gamzeceliikk/UGAN-Powertronics/EE464_HW#2.pdf

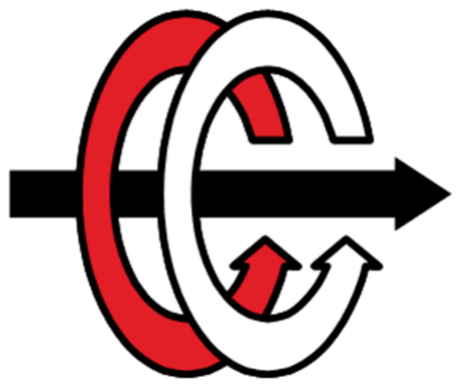
[picture p1: figure]

# ELECTRICAL & ELECTRONICS ENGINEERING DEPARTMENT

## STATIC POWER CONVERSION II

### FLYBACK CONVERTER DESIGN: SIMULATION RESULTS

by

Ahmet Can YULAF 2376234

Gamze ÇELİK 23043227

Utku Deniz ALTIOK 2347596

Ahmet Can YULAF | Gamze ÇELİK | Utku Deniz ALTIOK

### 1. Introduction

Isolated DC/DC converters have several benefits over non-isolated converters. The main reason for the isolation is safety. Flyback converter is one of the isolated DC/DC converter topologies. This report focuses on how to determine open-loop parameters for the 48W flyback converter and verification of the determined parameters.

### 2. Open-Loop Parameters Selection

Flyback converter has the following gain relation.
| V o = D 1−D *

NS
NP

* V
in
According to the gain relation of the converter,

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
−> 4 ≥

D
1−D

*

NS
NP
| | ≥ 2. 67
Moreover, duty cycle is desired to be less than or equal to 0.5. Thus, turn ratio of the
transformer is chosen as n = | and the switching frequency of the converter to be

NS
NP

= 4
designed as 50 kHz.

Given turn ratio and frequency, the following parameters can be computed as follows.

V

DS,max = V

in,max + V

| Reflected + V DS,max | * 0. 3 (due to leakage ringing)
0. 7V | So
DS,max = 18 + (48 + 0. 7) * 1/4 | V
DS,max
| | ≈ 45 V
| Dmax = V R V R+V in,min = 0. 505

P

in,max =

P
out,max
eff

(assuming %85 efficiency) = 48/0. 85 ≈ 56. 5 W

I

P =

2*P
| in,max
V
in,min
| *Dmax = 2*56.5
12*0.505 | ≈ 18. 65 A

L

p,max =

V
in,min

*Dmax
I
P

*f
sw

=

| 12*0.505
18.65*50000 | = 6. 5 * 10
| | −6 H = 6. 5 µH

For the core to be used is a ferrite core, with the assumption that BSat = 0.24 T. BSat values can be in the range of 0.2 - 0.34 Tesla according to papers. Moreover, we found a core that has 125 mm² Ae

N

P =

L
p,max

*I
P
BSat

*A
e
| = 6.5*10 −6 *18.65
0.24*0.000125 | ≈ 4 Turns
So, we will have 4 turns at the primary side. At this point, one issue about inductance factor of the core chosen arises. The problem is that primary inductance calculated from the given primary turns exceeds the primary inductance limit for the discontinuous conduction mode. However, datasheet contains any information about DC performance of the core. Therefore, it will be assumed that core will have 6.5 µH for 4 primary turns due to its non-provided DC performance. This issue will be investigated before the incorporation of the designed transformer.

I

p,rms = I
p,peak
| * Dmax

/3 = 18. 65 * 0. 505/3 = 7. 65 A

2 | Flyback Converter Design – Simulation Report

I

s,peak = I
P

* 1/4 = 4. 67 A I

s,rms = 4. 67 *

1−0.505
3 = 1. 9 A

According to the table above we should choose AWG23 for 50 kHz operation. However, it has a 0.729A maximum current capacity, so it can be wired as parallel.

For the primary side, wire should contain at least 11 cables to satisfy current condition. This means there will be 44 AWG23 cable at the window for primary. For Secondary only 3 parallel cables are needed for secondary wire. Thus, there will be 48 cables at the window. Each cable has 0.258 mm² area. There will be a total of 92 cables at the window, which makes 24 mm² winding area. Since they are wired as parallel, it will probably be higher, 30 mm² so to say. Winding area of the coil former is 75 mm²
, which makes fill factor 0.4. It is a reasonable fill factor.

V

RV,diode = V
out

+ V
in,max

* n = 48 + 18 * 4 = 120 V

According to the design guides VRRM should be at least 30% higher than VRV,diode and IF (average forward current) is at least 50% higher than the Is,rms

. So VRRM should be around 156 V and IF should be around 2.9 A

C

out,min =

I
out,max

*NCP
f
sw

*V
Ripple

NCP is the number of internal clock cycles needed by the control loop to reduce the duty cycle from maximum to minimum value. This usually takes around 10-20 switching periods.

Vo,ripple will be 1.44V if the ripple voltage is set to be 3% of the average output voltage.

So C
out,min =

1*15
50000*1.44 = 208. 3 * 10

−6
F = 208. 3 µF = 0. 21 mF

I

c,rms,min = I
s,rms

2 − I
Out

2 = 1. 62 A

ESR

max <

∆V
Out
I
s,peak

= 1. 44/1. 9 = 0. 76

Above calculations are decent except the capacitor value which is probably too high it has very low ripple in simulations so we try a different approach

∆V | . To stay in the safe region we shall
O

/V

O =

D
RCf = 0. 03 =

0.51
48*C*50000 => C = 7. 1 µF
use 10 µF

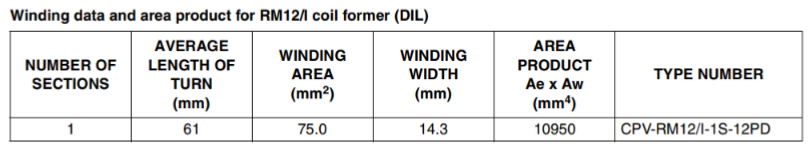
[picture p2: figure]

In the datasheet of the coil former, (https://www.digikey.com/en/products/detail/ferroxcube/CPV-RM12-I-1S-12PD-TZ/7034242) it says the average length of a single turn is 61 mm. AWG23 has 66.8 Ω/km resistance, which is 6. 68 * 10 Ω/m. As cables will be wired as

−5
parallel, the total resistance can be calculated as the formula given below.

ρ =

Number of Turns *61*6.68*10

−5
Number of Paralleled Cables

ρ

p =

4*61*6.68*10

−5
11 = 0. 0015Ω

ρ

s =

16*61*6.68*10

−5
3 | = 0. 022Ω

The AWG23 cable has 100% skin depth at the frequency about 50kHz. Therefore, AC resistance will be equal to DC resistance.

P

p,copper = I
RMS

2
* R = 7. 65

2
* 0. 0015 = 0. 09 W P s,copper = 1. 9

2
* 0. 022 = 0. 08 W

P

total,copper = P

s,copper + P

p,copper = 170 mWatts

L

M =

(V
in,min

*Dmax

)

2

2*Pin*f
sw

=

(12*0.505)

2
2*56.5*50000 = 6. 5 µH

∆I

L =

V
inMin

*Dmax
LM

*f
SW

=

12*0.505
6.5*10

−6
*50000

= 18. 65A

I

EDC =

P
in
V
in,min

*Dmax

=

56.5
12*0.505 = 9. 32A

I

DS,peak = I

EDC + ∆I/2 = 18. 65A

I

DS,rms = (3 * I
EDC

2
+ (∆I/2)

2
) * Dmax

/3 = 7. 65A

N

P,min =

LM

*I
Over
BSat

*A
e

* 10

6 = 4 turns

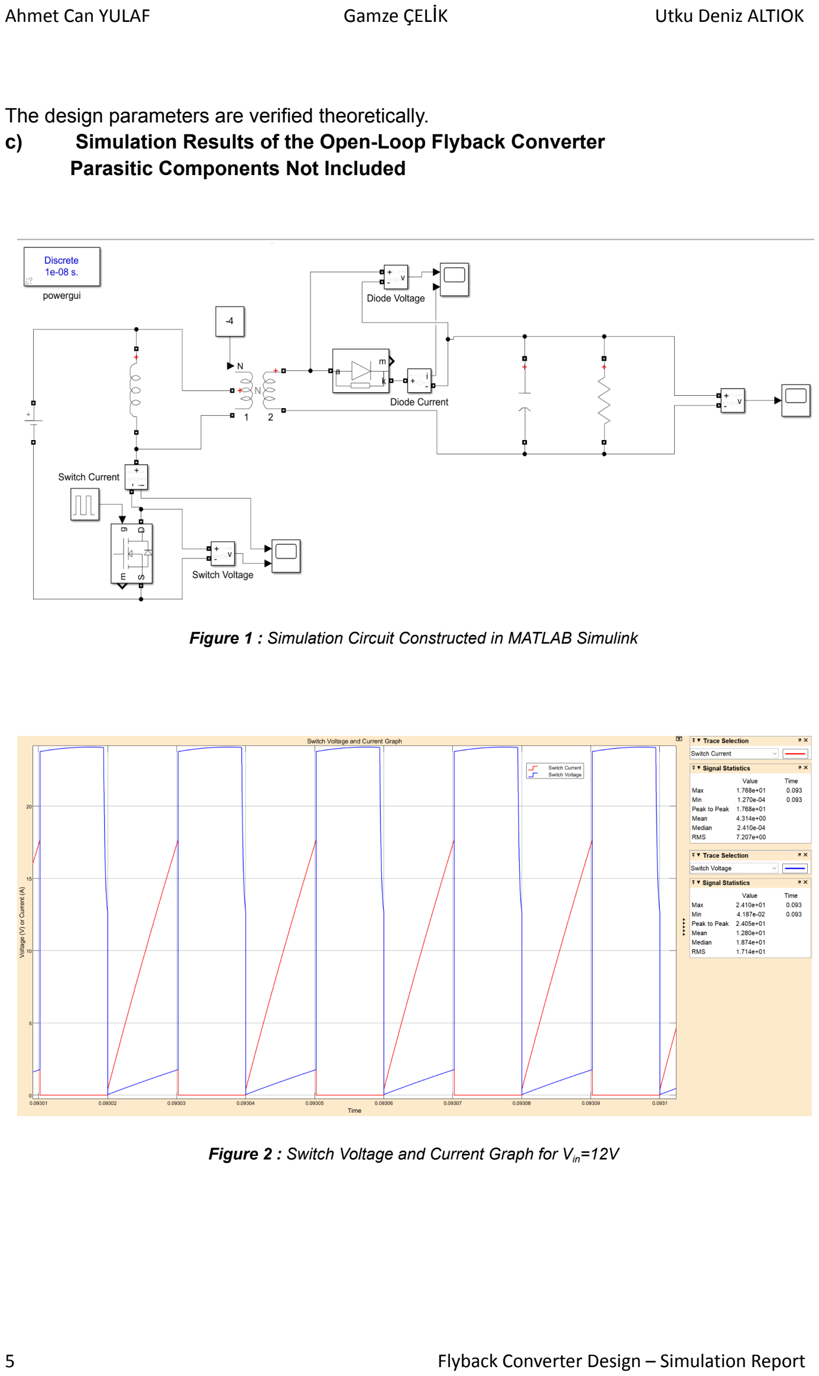
[picture p3: page 5]

The design parameters are verified theoretically.
c) Simulation Results of the Open-Loop Flyback Converter Parasitic Components Not Included

Figure 1 : Simulation Circuit Constructed in MATLAB Simulink

Figure 2 : Switch Voltage and Current Graph for Vin=12V

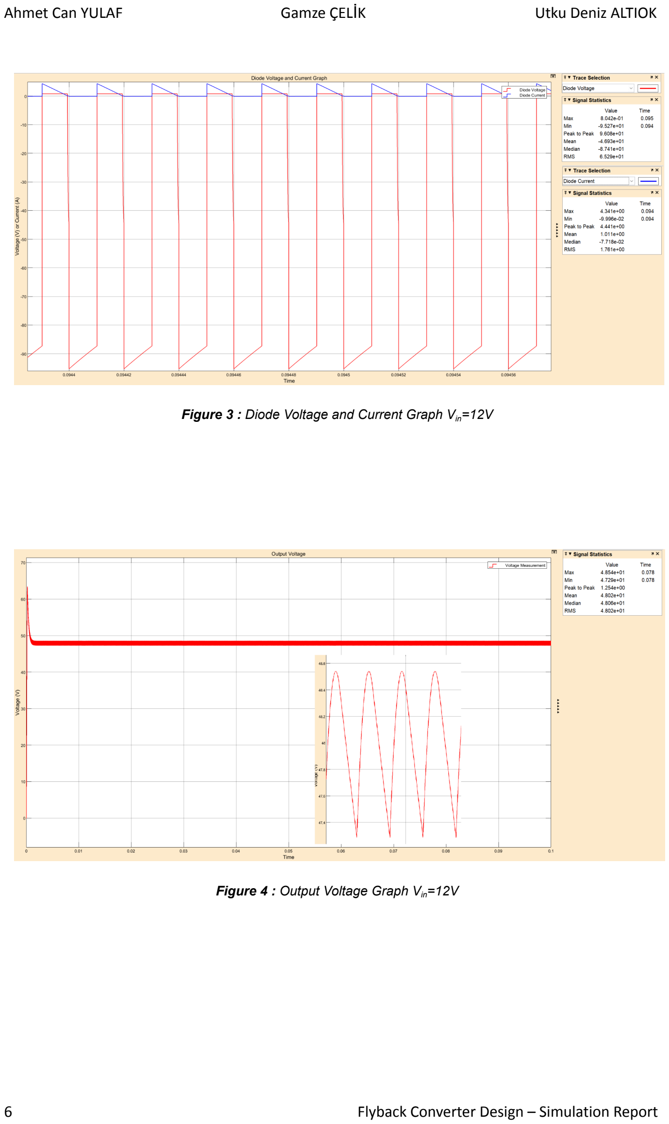
[picture p4: page 6]

Figure 3 : Diode Voltage and Current Graph Vin=12V

Figure 4 : Output Voltage Graph Vin=12V

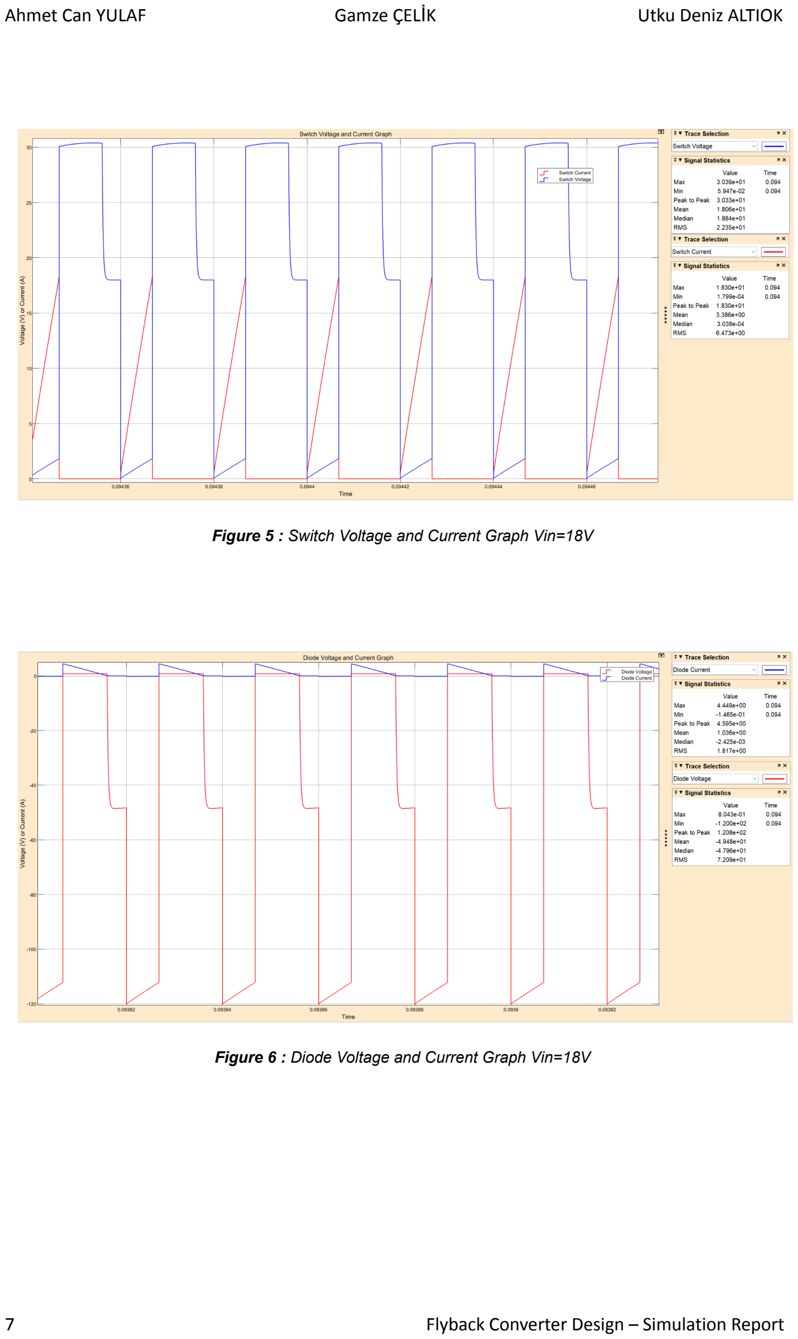
[picture p5: page 7]

Figure 5 : Switch Voltage and Current Graph Vin=18V

Figure 6 : Diode Voltage and Current Graph Vin=18V

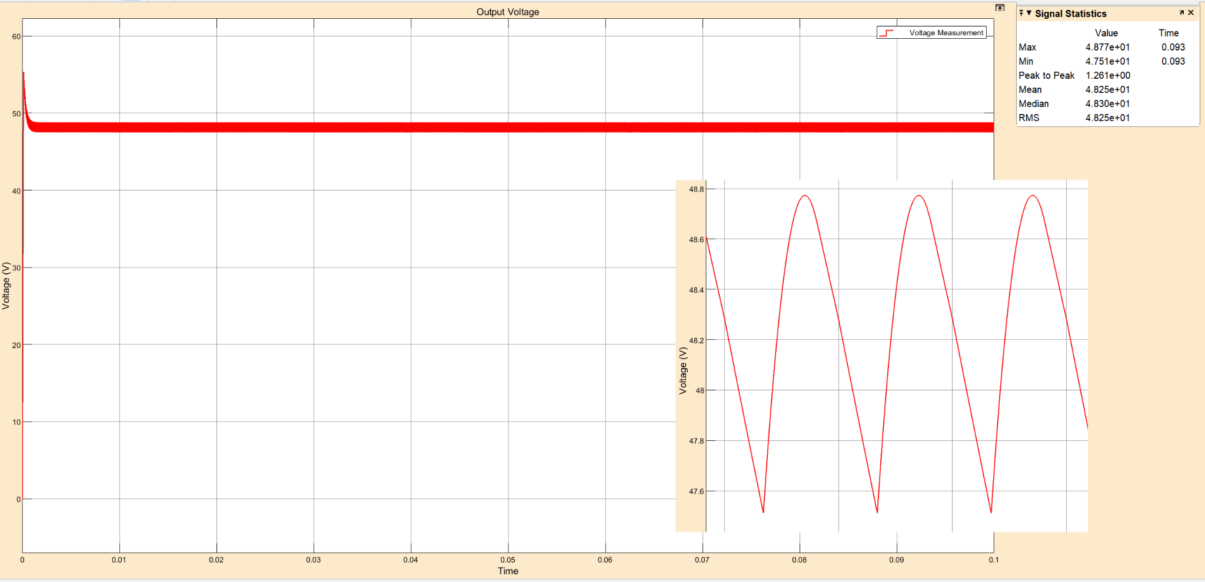
[picture p6: figure]

Figure 7 : Output Voltage Graph Vin=18

d)
DCM will occur at low Vin if it will occur, so at V | and we have N2/N1 =4, and
In = 12 V
Lm = 6.5 uH but it was chosen to operate at the vicinity of the boundary according to the design guides so let's assume it is 10 uH for this question to operate in the ccm mode. The
other values were ; f | .
SW = 50 kHz R = 48 Ω D = 0. 52 C | Out = 10 uF
so ∆I | so at the
L =

V
inMin

*Dmax LM *f SW
=

12*0.52 10*10 −6 *50000
= 12. 5A tℎen I | LAvg = 6. 25 A
secondary side 6.25/4= 1.56 A

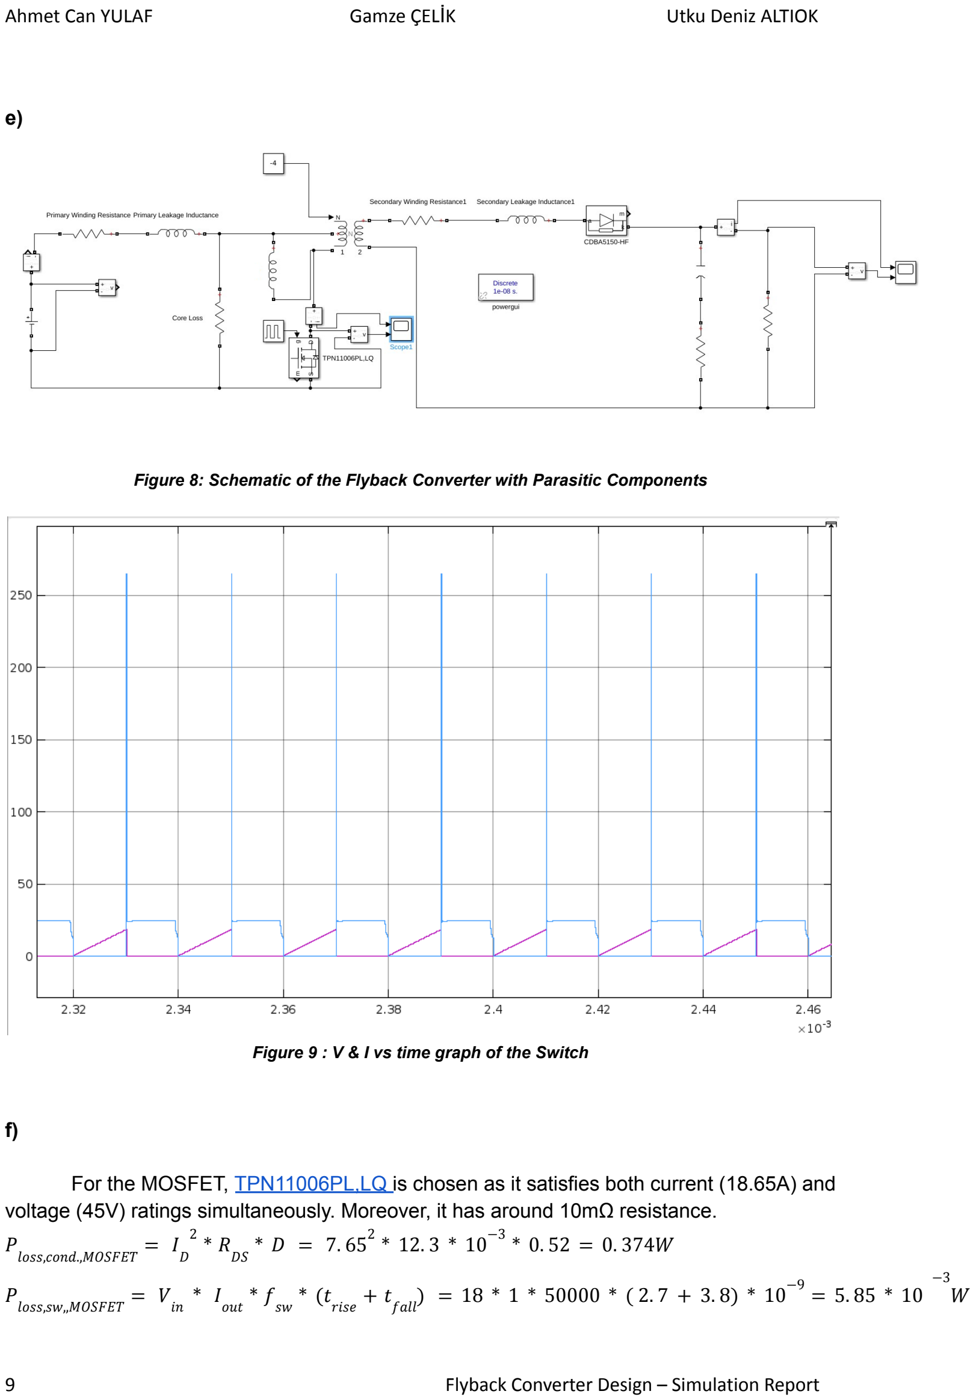
[picture p7: page 9]

e)

Figure 8: Schematic of the Flyback Converter with Parasitic Components

Figure 9 : V & I vs time graph of the Switch

f)

For the MOSFET, TPN11006PL,LQ (https://www.digikey.com/en/products/detail/toshiba-semiconductor-and-storage/TPN11006PL-LQ/10447100) is chosen as it satisfies both current (18.65A) and voltage (45V) ratings simultaneously. Moreover, it has around 10mΩ resistance.

P

loss,cond.,MOSFET = I
D

2
* R
DS

* D = 7. 65

2
* 12. 3 * 10

−3
* 0. 52 = 0. 374W

P

loss,sw,,MOSFET = V
in

* I
out

* f
sw

* (t

rise + t
fall

) = 18 * 1 * 50000 * ( 2. 7 + 3. 8) * 10

−9 = 5. 85 * 10

−3
W

For the diode, CDBA5150-HF (https://www.digikey.com/en/products/detail/comchip-technology/CDBA5150-HF/3308146) is chosen as it satisfies both current (1.9Aavg & 4.6Apeak) and voltage (120V) RATİNGS SİMULTANEOUSLY. Moreover, it has around 0.75V forward voltage drop on it.

P

loss,cond,,diode = V
f

* I
avg

* (1 − D) = 0. 87 * 1. 9 * 0. 48 = 0. 793W Switching losses on the schottky diodes are negligible

For the output capacitor, ESK106M100AE3EA (https://www.digikey.com/en/products/detail/kemet/ESK106M100AE3EA/9448267) is chosen. According to the datasheet, ESR is calculated with the formula given below.

R

ESR =

tanδ
ω*C = 63. 66mΩ

Core loss under specific conditions has been provided by the core manufacturer. However, there exists no data at 50kHz and 0.24T. However, there is a direct relation between frequency and core loss. Therefore, the core loss will be approximated as the half of the loss at 100kHz.

Leakage inductance is subjected to the winding method. Therefore, there can not be formulation about leakage inductance. For this converter, leakage inductance will be assumed to be 1% of the magnetizing inductance and the secondary side is assumed to be reflected inductance of primary leakage inductance.

L

l,1 = 0. 01 * L

M =

L
l,2
n

2 −> L

l,2 = L
l,1

* n

2

# References

1 https://www.mouser.com/pdfdocs/2-8.pdf
2 https://www.digikey.com/en/products/detail/ferroxcube/CPV-RM12-I-1S-12PD-TZ/7034242 3 https://www.ferroxcube.com/upload/media/product/file/Pr_ds/RM12_ILP.pdf
4 https://tr.farnell.com/awg-donusturme-hesaplayicisi
5 https://www.onsemi.jp/pub/collateral/an-4140jp.pdf
