gamzeceliikk/UGAN-Powertronics/Simulation Plots/Diode Current and Voltage Graph Vin=12, D=0.52.png

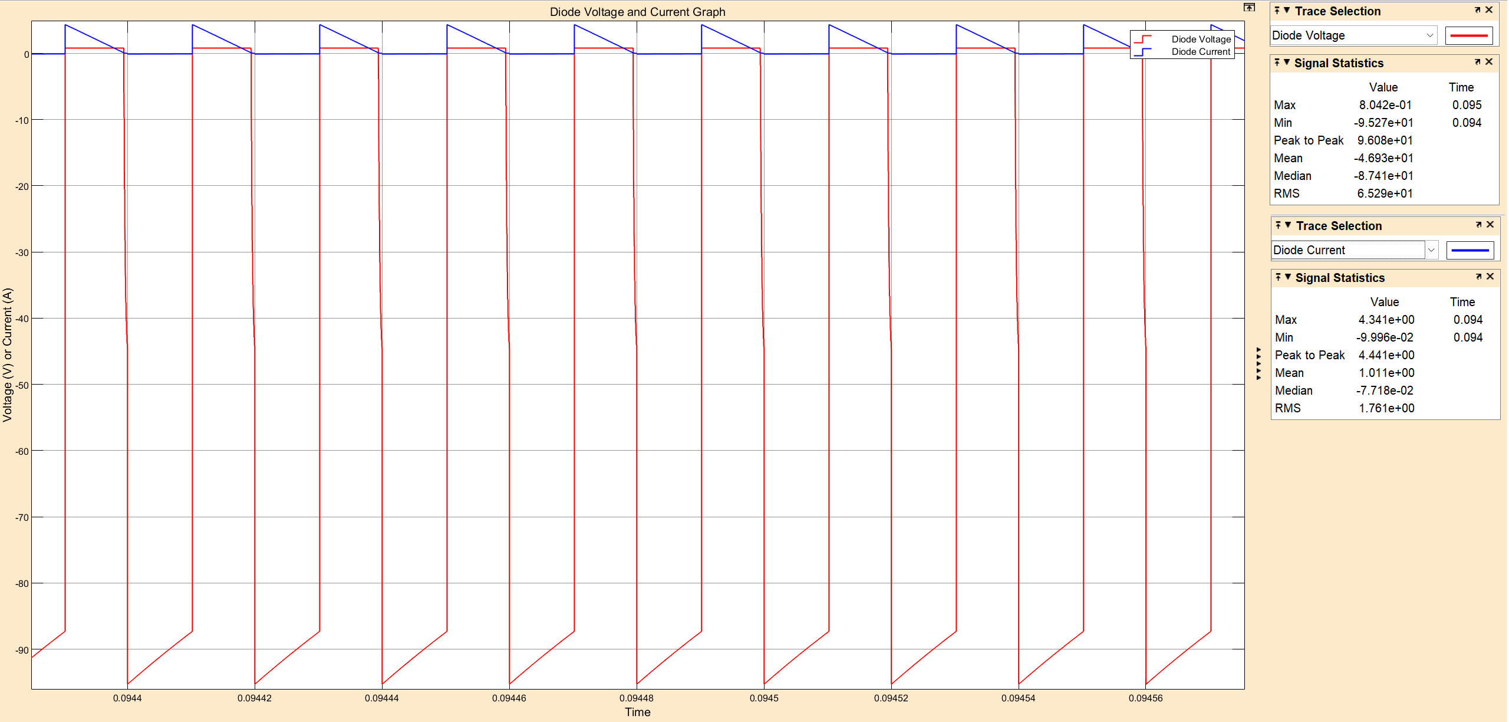
Simulation Plots/Diode Current and Voltage Graph Vin=12, D=0.52.png
