gamzeceliikk/UGAN-Powertronics/Simulation Plots/Diode Current and Voltage Graph Vin=18, D=0.34.png

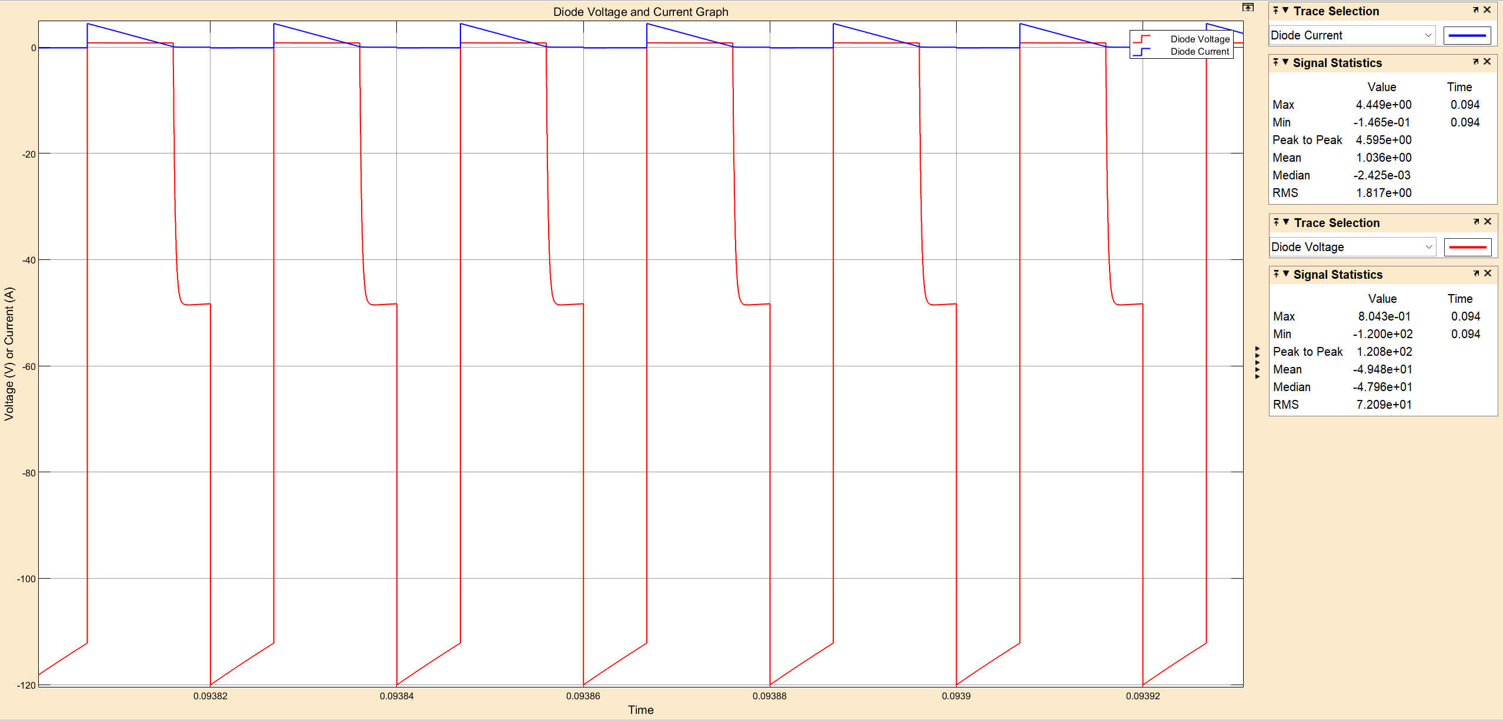
Simulation Plots/Diode Current and Voltage Graph Vin=18, D=0.34.png
