gamzeceliikk/UGAN-Powertronics/Simulation Plots/Output Voltage Vin=12  D=0.52.png

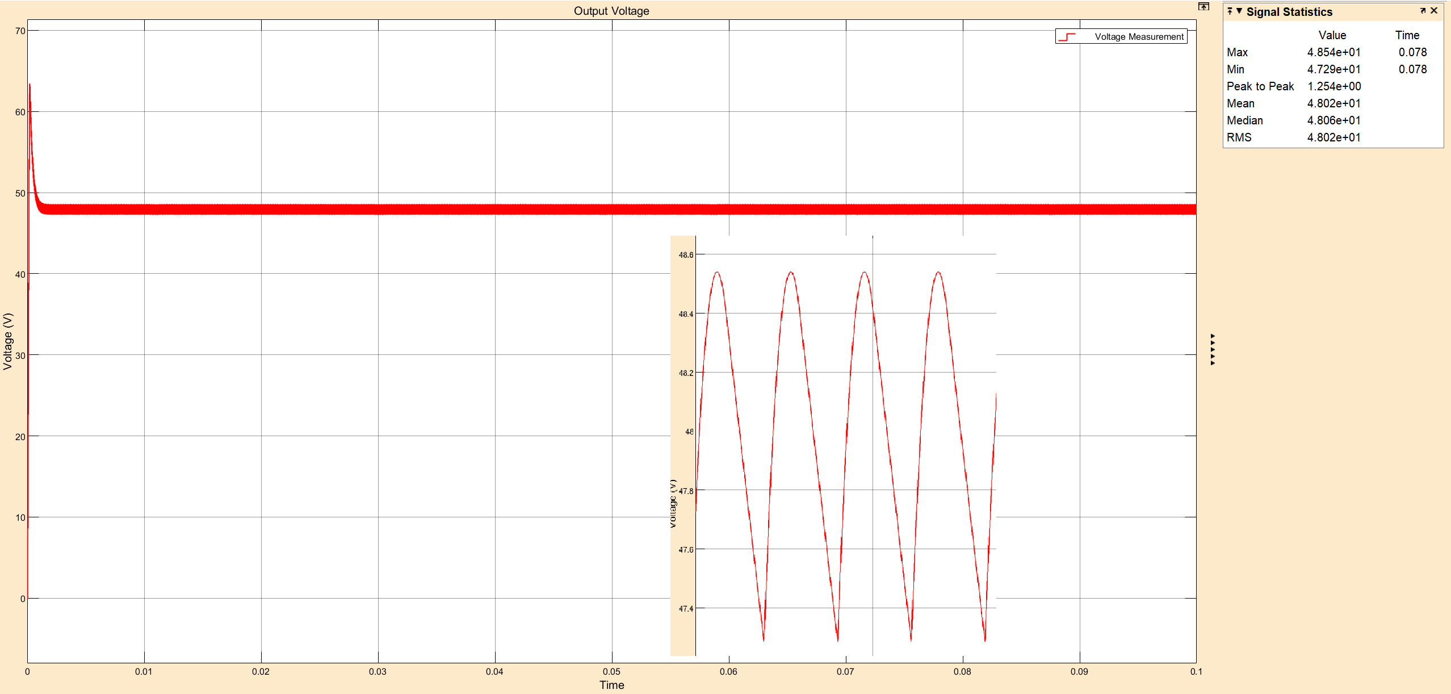
Simulation Plots/Output Voltage Vin=12 D=0.52.png
