gamzeceliikk/UGAN-Powertronics/Simulation Plots/Output Voltage Vin=18  D=0.34.png

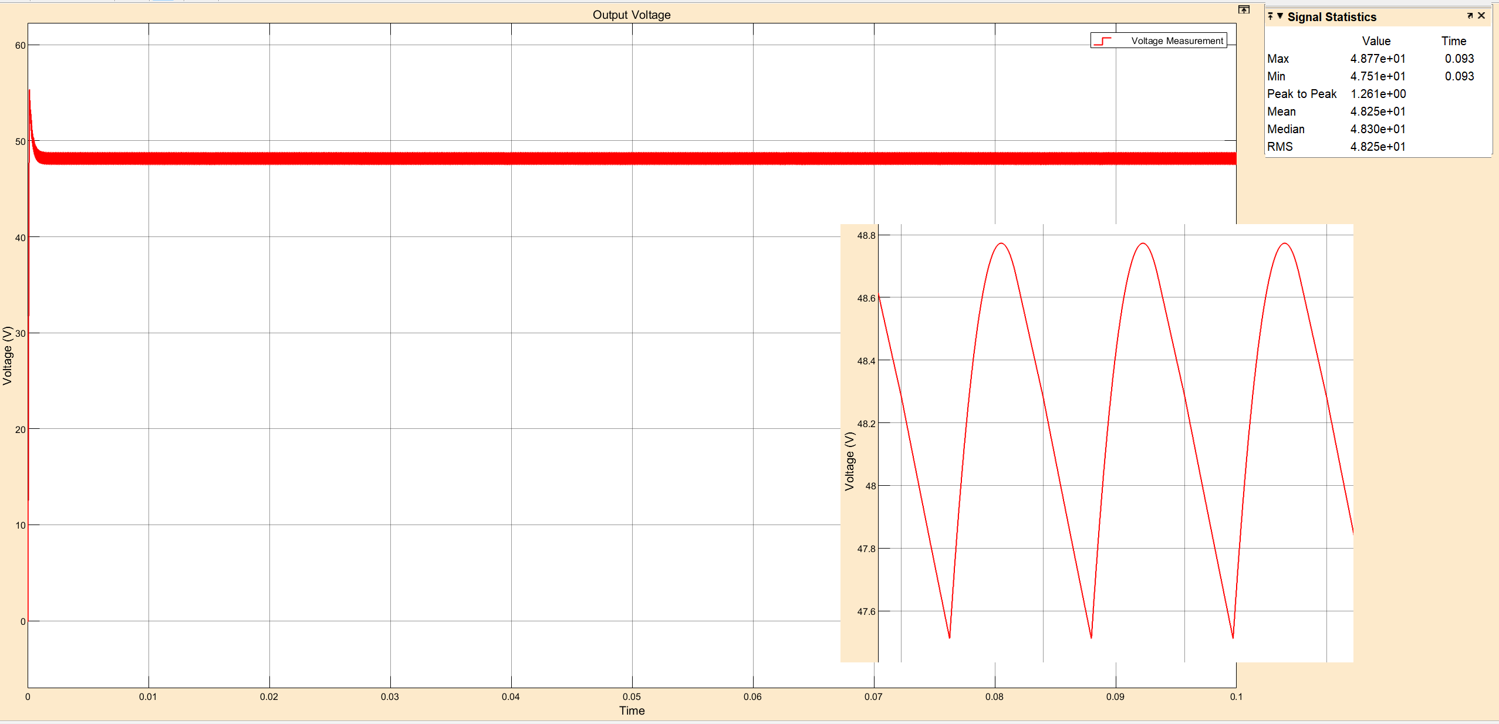
Simulation Plots/Output Voltage Vin=18 D=0.34.png
