gamzeceliikk/UGAN-Powertronics/Simulation Plots/Switch Voltage and Current Graph Vin=12 D=0.52.png

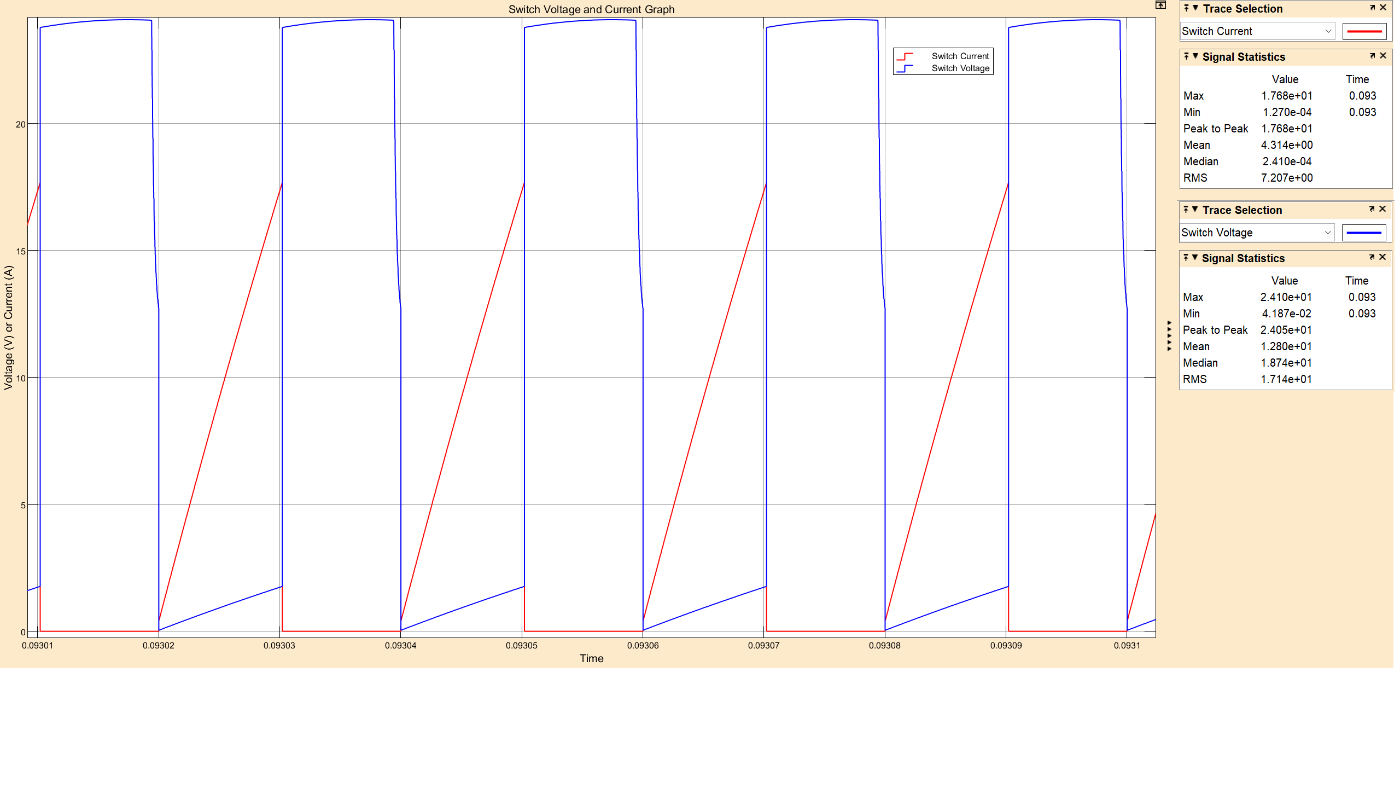
Simulation Plots/Switch Voltage and Current Graph Vin=12 D=0.52.png
