gamzeceliikk/UGAN-Powertronics/Simulation Plots/Switch Voltage and Current Graph Vin=18 D=0.34.png

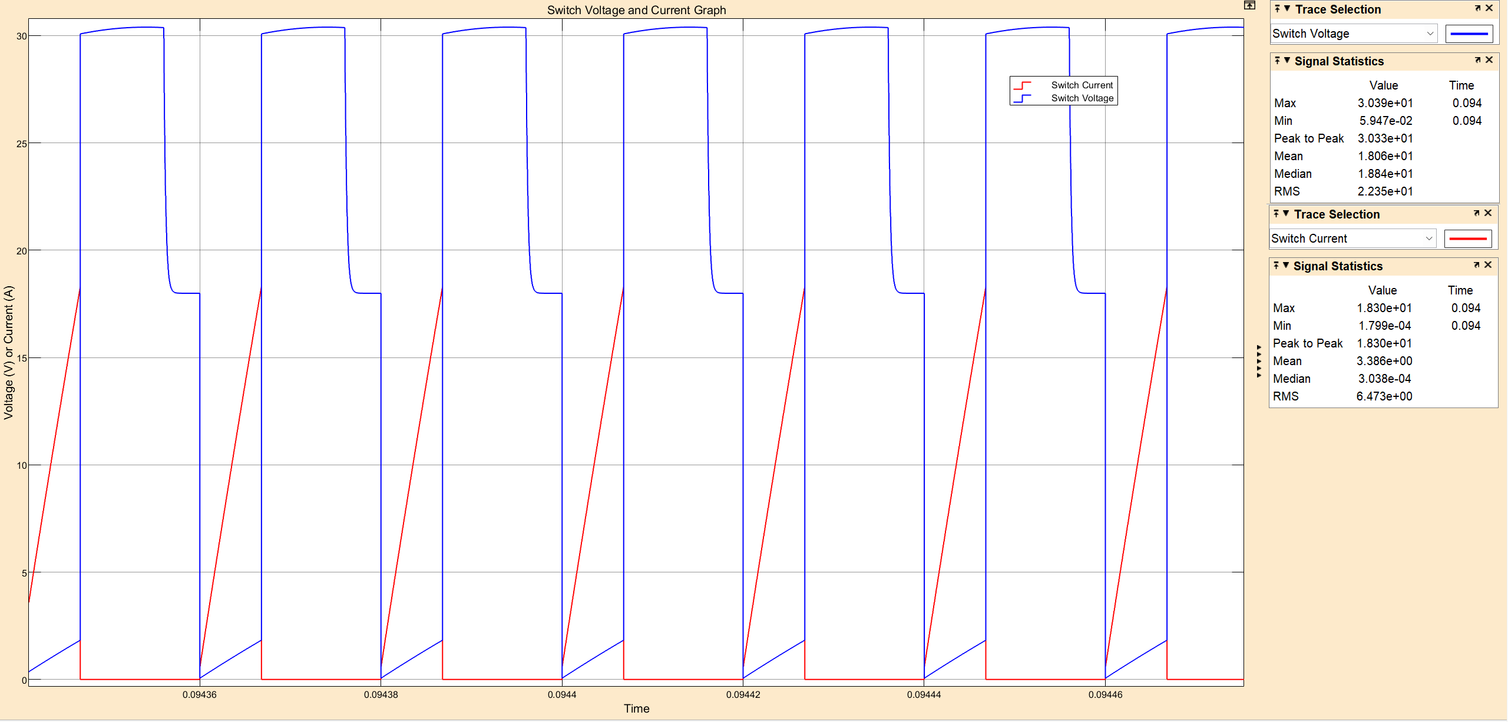
Simulation Plots/Switch Voltage and Current Graph Vin=18 D=0.34.png
