gamzeceliikk/UGAN-Powertronics/design1.pdf

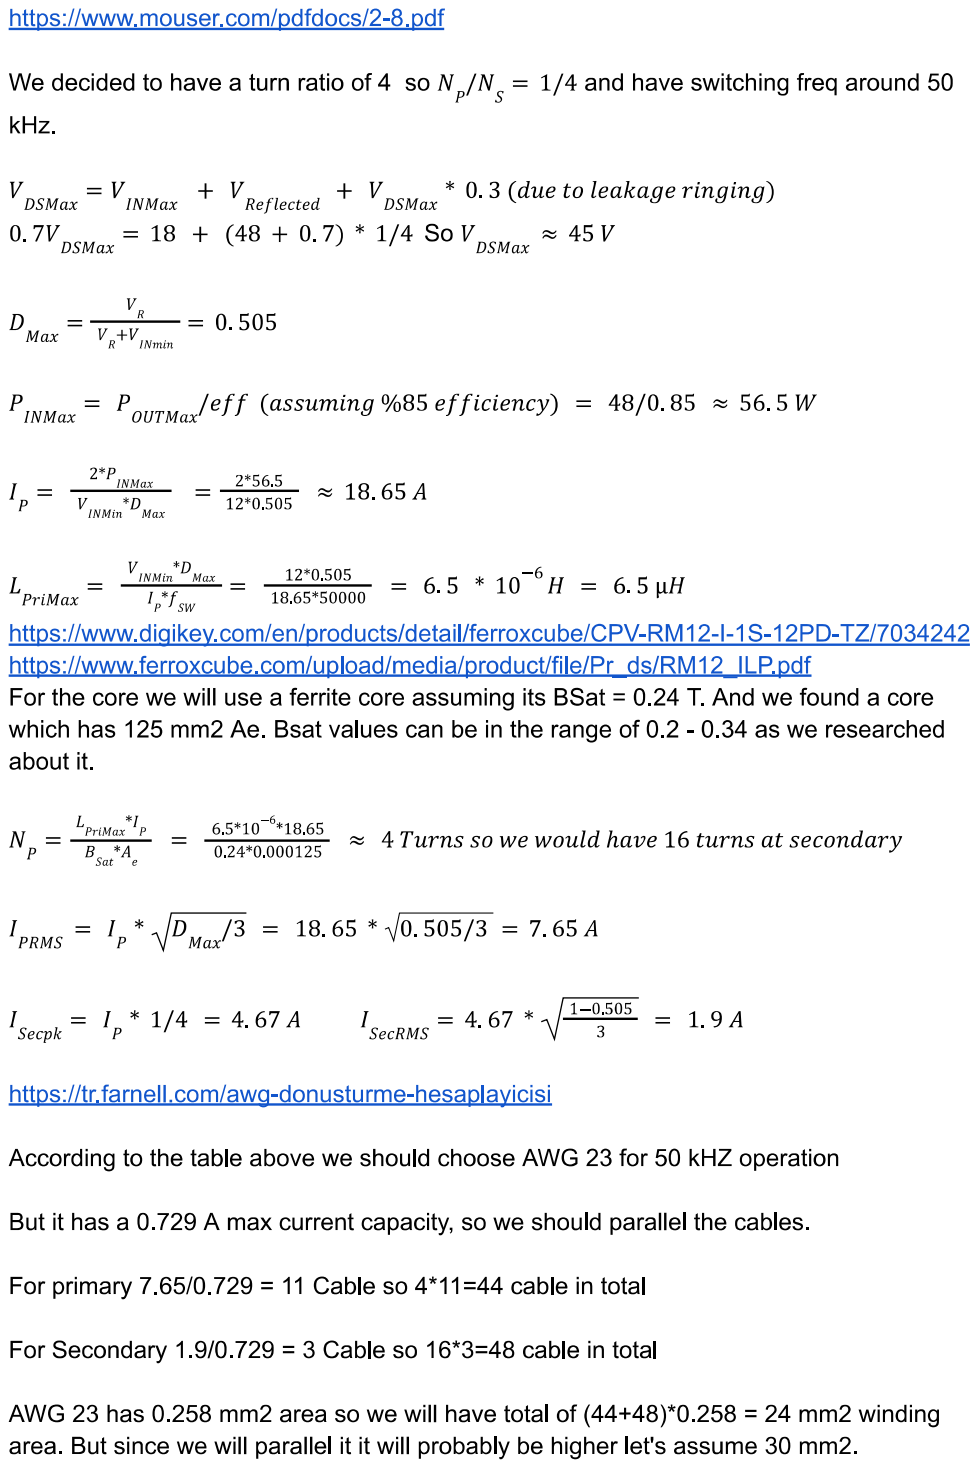
[picture p14: page 1]

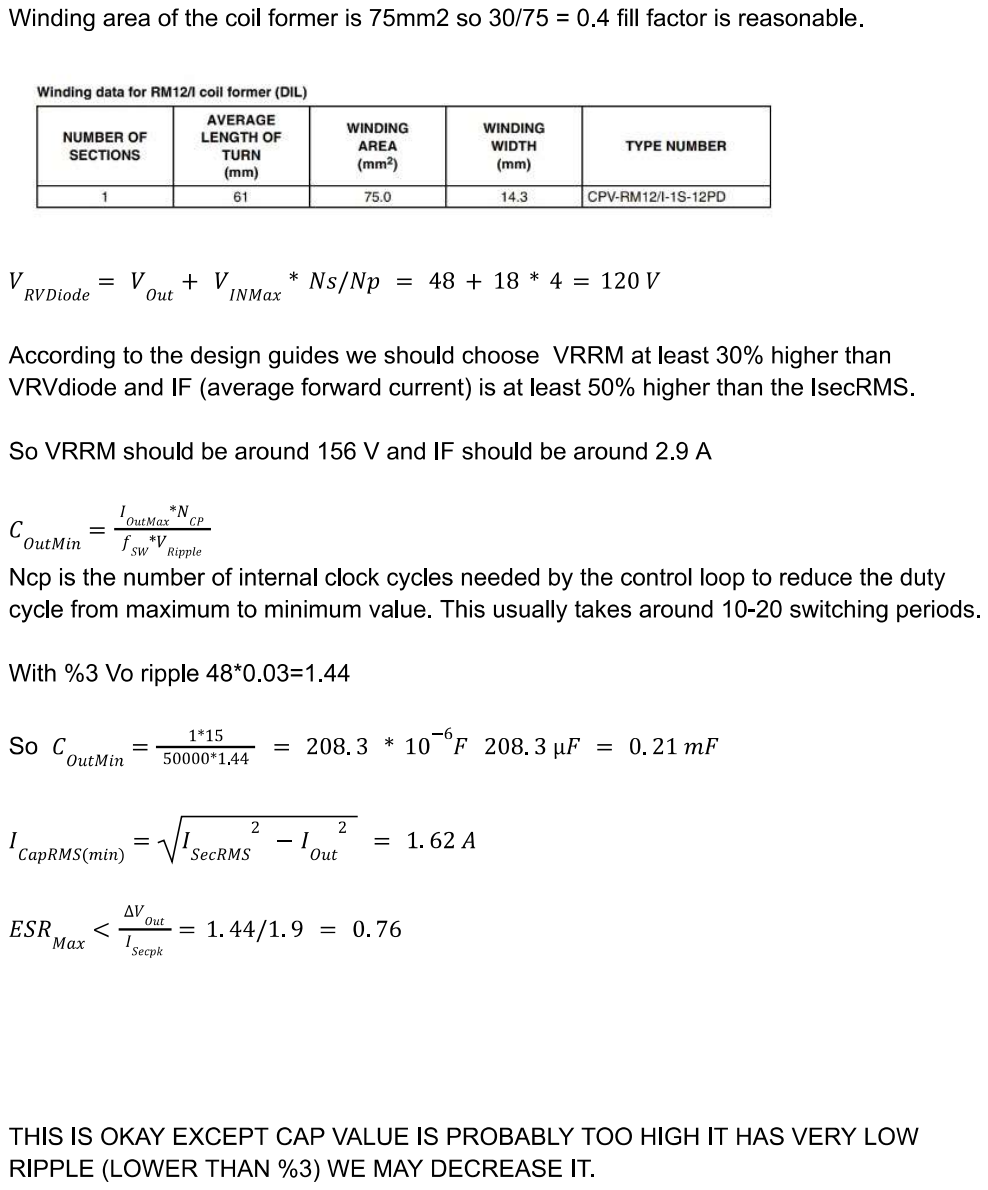
[picture p15: page 2]
