gamzeceliikk/UGAN-Powertronics/FlyBackFullCCT.asc

C1: cap; 220p
C2: cap; 470p
C3: cap; 2.2n
C4: cap; 1n
C5: cap; 1µ
C7: cap; 100n
C8: cap; 1n
C9: cap; 1µ
C10: cap; 1n
C11: cap; 1µ
C12: cap; 100n
C13: cap; 220n
C14: cap; 1n
C15: cap; 18µ
C16: cap; 4.7n
C17: cap; 470p
D1: schottky; RB218T150NZ
D2: schottky; RB168LAM100
D4: schottky; RB168LAM100
L1: ind2; 8µ
L2: ind2; 128µ
M1: nmos; IRFH5015
R1: res; 4.7k
R2: res; 2.2k
R3: res; 10
R4: res; 2.2k
R5: res; 33k
R6: res; 22k
R7: res; 1.2k
R8: res; 1k
R9: res; 1.5k
R10: res; 5k
R11: res; 1k
R12: res; 10k
R13: res; 4.7k
R14: res; 75k
R15: res; 10k
R16: res; 47m
R17: res; 48
R18: res; 10k
R19: res; 100
R20: res; 330m
R21: res; 200
R22: res; 1k
U1: LT1243
U2: tl431
U3: 4N25
V1: voltage; 12
Named nets: 0, G2, IN, OUT
K L1 L2 0.985
.include C:\\Users\\kmesn\\AppData\\Local\\LTspice\\lib\\sub/tl431.mod
.lib C:\\Users\\kmesn\\AppData\\Local\\LTspice\\lib\\sub/tl431.lib
.tran 0 0.005 0
