gamzeceliikk/UGAN-Powertronics/PCB/flyback_48V_48W.kicad_pcb

## KiCad design PCB/flyback_48V_48W.kicad_pcb (2023-06-15)

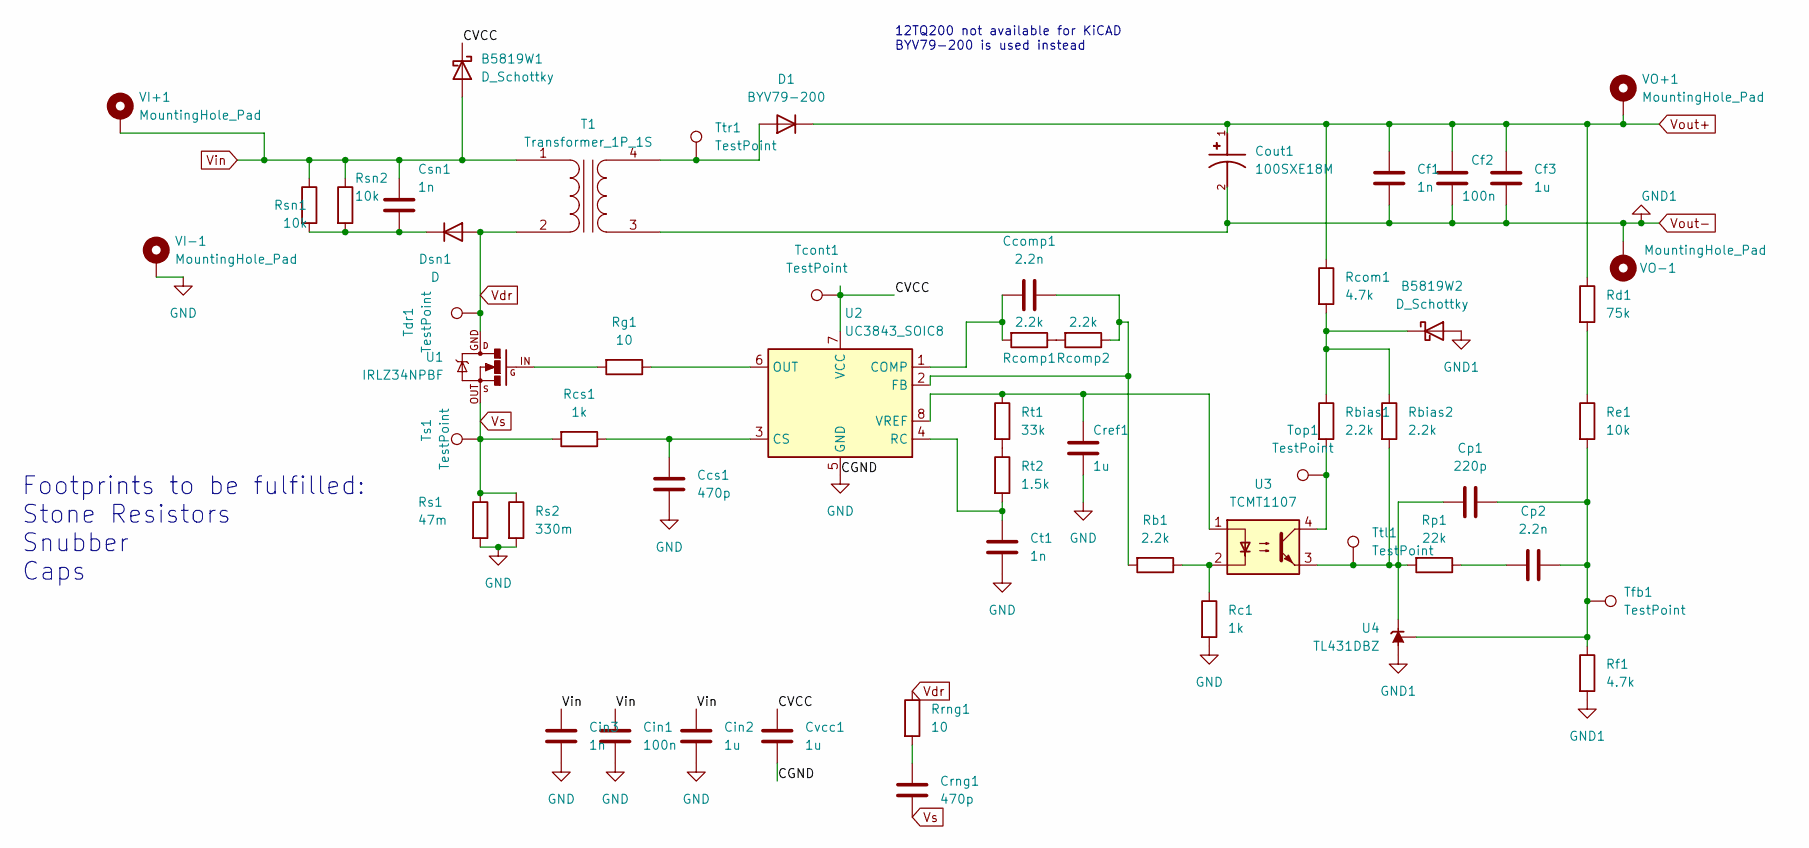
[picture p16: schematic flyback_48V_48W.kicad_sch]

Parts:
B5819W1, B5819W2: D_Schottky; D_SOD-123
Ccomp1: 2.2n; C_1206_3216Metric_Pad1.33x1.80mm_HandSolder
Ccs1: 470p; C_1206_3216Metric_Pad1.33x1.80mm_HandSolder
Cf1: 1n; C_1206_3216Metric_Pad1.33x1.80mm_HandSolder
Cf2: 100n; C_1206_3216Metric_Pad1.33x1.80mm_HandSolder
Cf3: 1u; C_1206_3216Metric_Pad1.33x1.80mm_HandSolder
Cin1: 100n; C_1206_3216Metric_Pad1.33x1.80mm_HandSolder
Cin2: 1u; C_1206_3216Metric_Pad1.33x1.80mm_HandSolder
Cin3: 1n; C_1206_3216Metric_Pad1.33x1.80mm_HandSolder
Cout1: 100SXE18M; CAPPRD500W60D1000H1300; PARTREV 5-Mar-21
Cp1: 220p; C_1206_3216Metric_Pad1.33x1.80mm_HandSolder
Cp2: 2.2n; C_1206_3216Metric_Pad1.33x1.80mm_HandSolder
Cref1: 1u; C_1206_3216Metric_Pad1.33x1.80mm_HandSolder
Crng1: 470p; C_1206_3216Metric_Pad1.33x1.80mm_HandSolder
Csn1: 1n; C_1206_3216Metric_Pad1.33x1.80mm_HandSolder
Ct1: 1n; C_1206_3216Metric_Pad1.33x1.80mm_HandSolder
Cvcc1: 1u; C_1206_3216Metric_Pad1.33x1.80mm_HandSolder
D1: BYV79-200; TO-220-2_Vertical
Dsn1: D; D_SOD-123
Rb1: 2.2k; R_1206_3216Metric_Pad1.30x1.75mm_HandSolder
Rbias1, Rbias2: 2.2k; R_1206_3216Metric_Pad1.30x1.75mm_HandSolder
Rc1: 1k; R_1206_3216Metric_Pad1.30x1.75mm_HandSolder
Rcom1: 4.7k; R_1206_3216Metric_Pad1.30x1.75mm_HandSolder
Rcomp1, Rcomp2: 2.2k; R_1206_3216Metric_Pad1.30x1.75mm_HandSolder
Rcs1: 1k; R_1206_3216Metric_Pad1.30x1.75mm_HandSolder
Rd1: 75k; R_1206_3216Metric_Pad1.30x1.75mm_HandSolder
Re1: 10k; R_1206_3216Metric_Pad1.30x1.75mm_HandSolder
Rf1: 4.7k; R_1206_3216Metric_Pad1.30x1.75mm_HandSolder
Rg1: 10; R_1206_3216Metric_Pad1.30x1.75mm_HandSolder
Rp1: 22k; R_1206_3216Metric_Pad1.30x1.75mm_HandSolder
Rrng1: 10; R_1206_3216Metric_Pad1.30x1.75mm_HandSolder
Rs1: 47m; R_2512_6332Metric_Pad1.40x3.35mm_HandSolder
Rs2: 330m; R_2512_6332Metric_Pad1.40x3.35mm_HandSolder
Rsn1, Rsn2: 10k; R_1206_3216Metric_Pad1.30x1.75mm_HandSolder
Rt1: 33k; R_1206_3216Metric_Pad1.30x1.75mm_HandSolder
Rt2: 1.5k; R_1206_3216Metric_Pad1.30x1.75mm_HandSolder
T1: Transformer_1P_1S; RM12_B65816
Tcont1: TestPoint; TestPoint_THTPad_D1.0mm_Drill0.5mm
Tdr1: TestPoint; TestPoint_THTPad_D1.0mm_Drill0.5mm
Tfb1: TestPoint; TestPoint_THTPad_D1.0mm_Drill0.5mm
Top1: TestPoint; TestPoint_THTPad_D1.0mm_Drill0.5mm
Ts1: TestPoint; TestPoint_THTPad_D1.0mm_Drill0.5mm
Ttl1: TestPoint; TestPoint_THTPad_D1.0mm_Drill0.5mm
Ttr1: TestPoint; TestPoint_THTPad_D1.0mm_Drill0.5mm
U1: IRLZ34NPBF; TO-220_with_heatsink
U2: UC3843_SOIC8; SOIC-8_3.9x4.9mm_P1.27mm
U3: TCMT1107; SOP-4_4.4x2.6mm_P1.27mm
U4: TL431DBZ; SOT-23
VI+1: MountingHole_Pad; MountingHole_4.3mm_M4_DIN965_Pad_TopBottom
VI-1: MountingHole_Pad; MountingHole_4.3mm_M4_DIN965_Pad_TopBottom
VO+1: MountingHole_Pad; MountingHole_4.3mm_M4_DIN965_Pad_TopBottom
VO-1: MountingHole_Pad; MountingHole_4.3mm_M4_DIN965_Pad_TopBottom

Connections:
/CVCC: B5819W1.1 (K), Cvcc1.1, Tcont1.1, U2.7 (VCC)
GND: Ccs1.2, Cin1.2, Cin2.2, Cin3.2, Cref1.2, Ct1.2, Cvcc1.2, Rc1.2, Rs1.2, Rs2.2, U2.5 (GND), VI-1.1
unnamed: B5819W2.1 (K), Rbias1.1, Rbias2.1, Rcom1.2
unnamed: Ccomp1.1, Rb1.2, Rcomp2.1, U2.2 (FB)
unnamed: Ccomp1.2, Rcomp1.2, U2.1 (COMP)
unnamed: Ccs1.1, Rcs1.1, U2.3 (CS)
unnamed: Cp1.1, Cp2.1, Re1.2, Rf1.1, Tfb1.1, U4.2 (REF)
unnamed: Cp1.2, Rbias2.2, Rp1.2, Ttl1.1, U3.3, U4.1 (K)
unnamed: Cp2.2, Rp1.1
unnamed: Cref1.1, Rt1.1, U2.8 (VREF), U3.1
unnamed: Crng1.1, Rrng1.2
unnamed: Csn1.2, Dsn1.1 (K), Rsn1.2, Rsn2.2
unnamed: Ct1.1, Rt2.2, U2.4 (RC)
unnamed: D1.2 (A), T1.4 (SB), Ttr1.1
unnamed: Rb1.1, Rc1.1, U3.2
unnamed: Rbias1.2, Top1.1, U3.4
unnamed: Rcomp1.1, Rcomp2.2
unnamed: Rd1.2, Re1.1
unnamed: Rg1.1, U2.6 (OUT)
unnamed: Rg1.2, U1.IN
unnamed: Rt1.2, Rt2.1
Vdr: Dsn1.2 (A), Rrng1.1, T1.2 (AB), Tdr1.1, U1.GND
Vin: B5819W1.2 (A), Cin1.1, Cin2.1, Cin3.1, Csn1.1, Rsn1.1, Rsn2.1, T1.1 (AA), VI+1.1
Vout+: Cf1.1, Cf2.1, Cf3.1, Cout1.1, D1.1 (K), Rcom1.1, Rd1.1, VO+1.1
Vout-: B5819W2.2 (A), Cf1.2, Cf2.2, Cf3.2, Cout1.2, Rf1.2, T1.3 (SA), U4.3 (A), VO-1.1
Vs: Crng1.2, Rcs1.2, Rs1.1, Rs2.1, Ts1.1, U1.OUT

Notes on the sheet:
12TQ200 not available for KiCAD BYV79-200 is used instead
Footprints to be fulfilled: Stone Resistors Snubber Caps

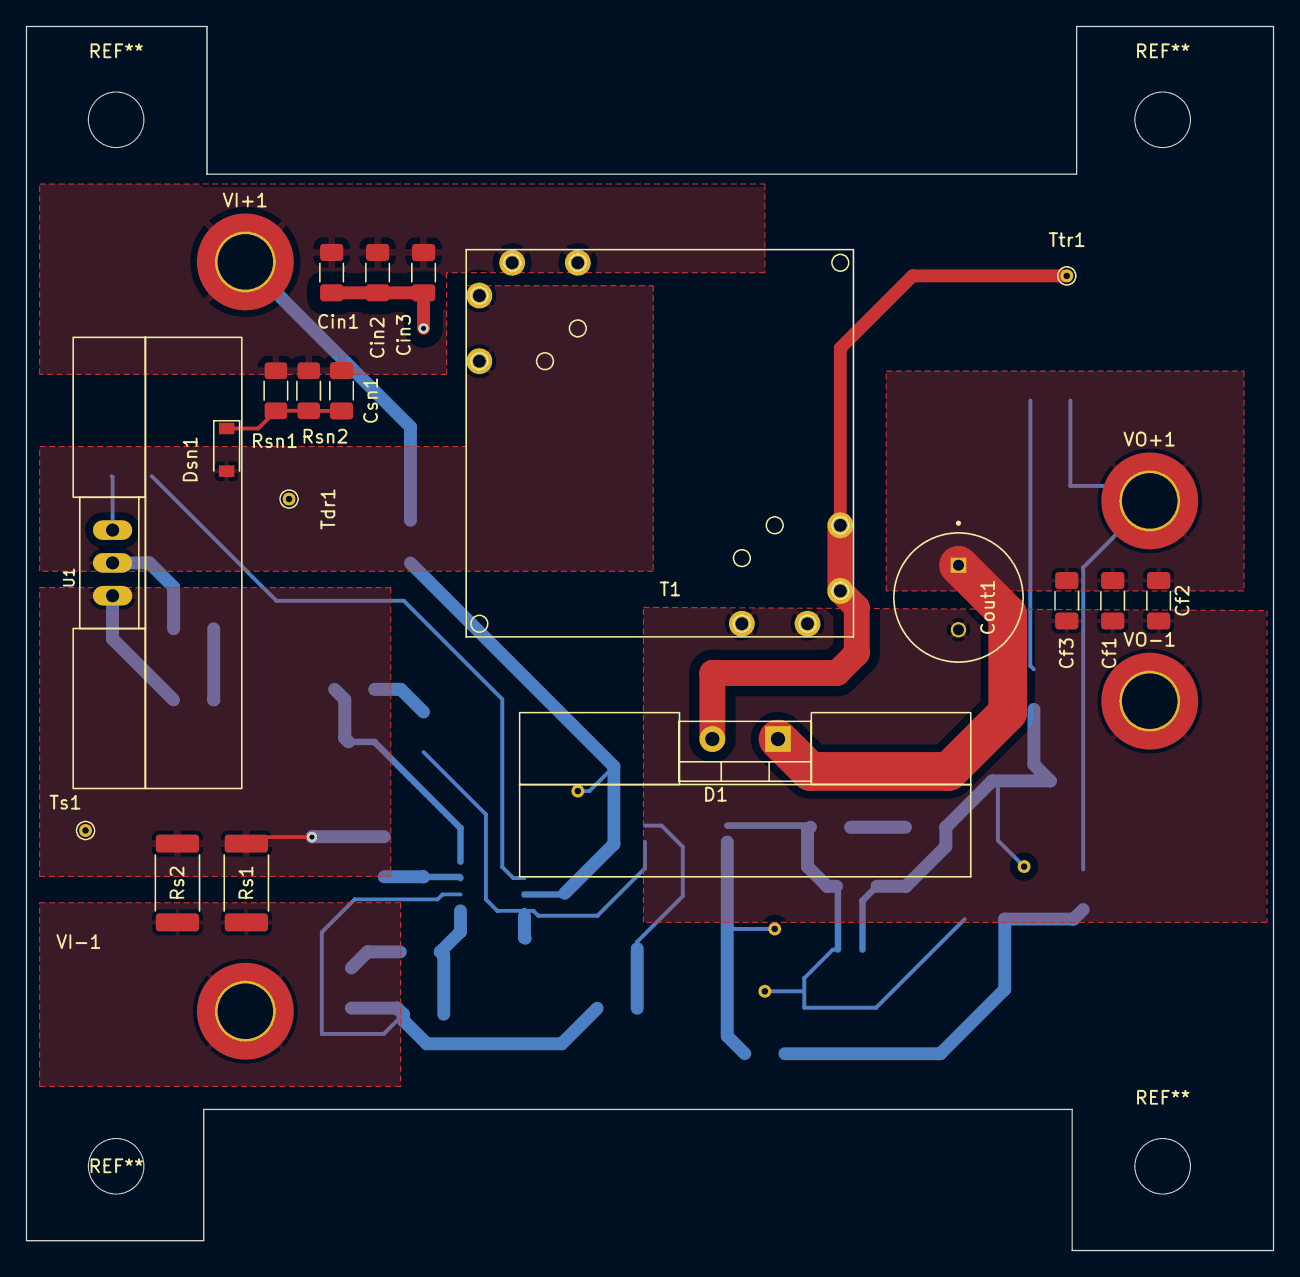
[picture p17: board flyback_48V_48W.kicad_pcb from above]

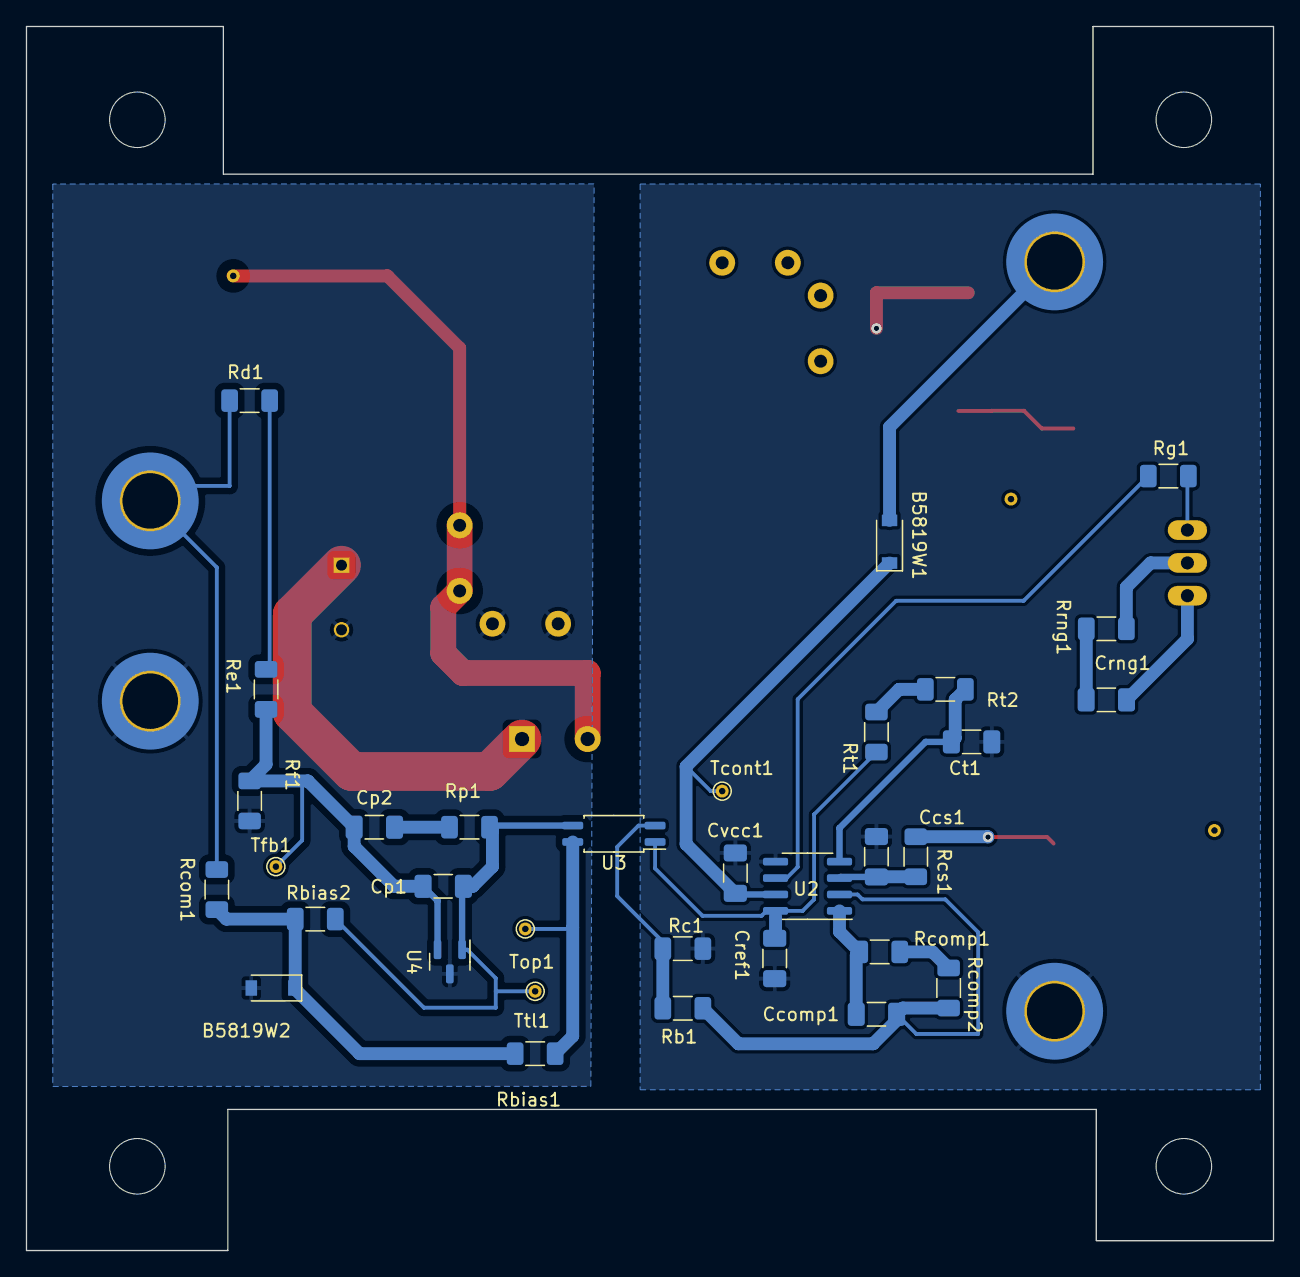
[picture p18: board flyback_48V_48W.kicad_pcb from below]

Board: 2 copper layers, 96.5 x 94.7 mm, 56 parts (33 on the bottom side), 26 nets.
