gamzeceliikk/UGAN-Powertronics/(commit log)

2023-05-05 comprehensive simulation file
    All potential losses (core losses, winding losses, leakage inductance, diode and MOSFET on resistance, capacitor ESR) are included.
2023-06-13 Schematic PCB Gerber and Drill Files
2023-06-13 Gerber Files
2023-06-13 Drill Files
2023-06-13 Kicad schematic, pcb, gerber, drill files
2023-06-27 Full circuit simulaiton
